MyKl-Y/MY-MP3/MY-MP3.kicad_pcb

## KiCad design MY-MP3.kicad_pcb (2025-10-29)

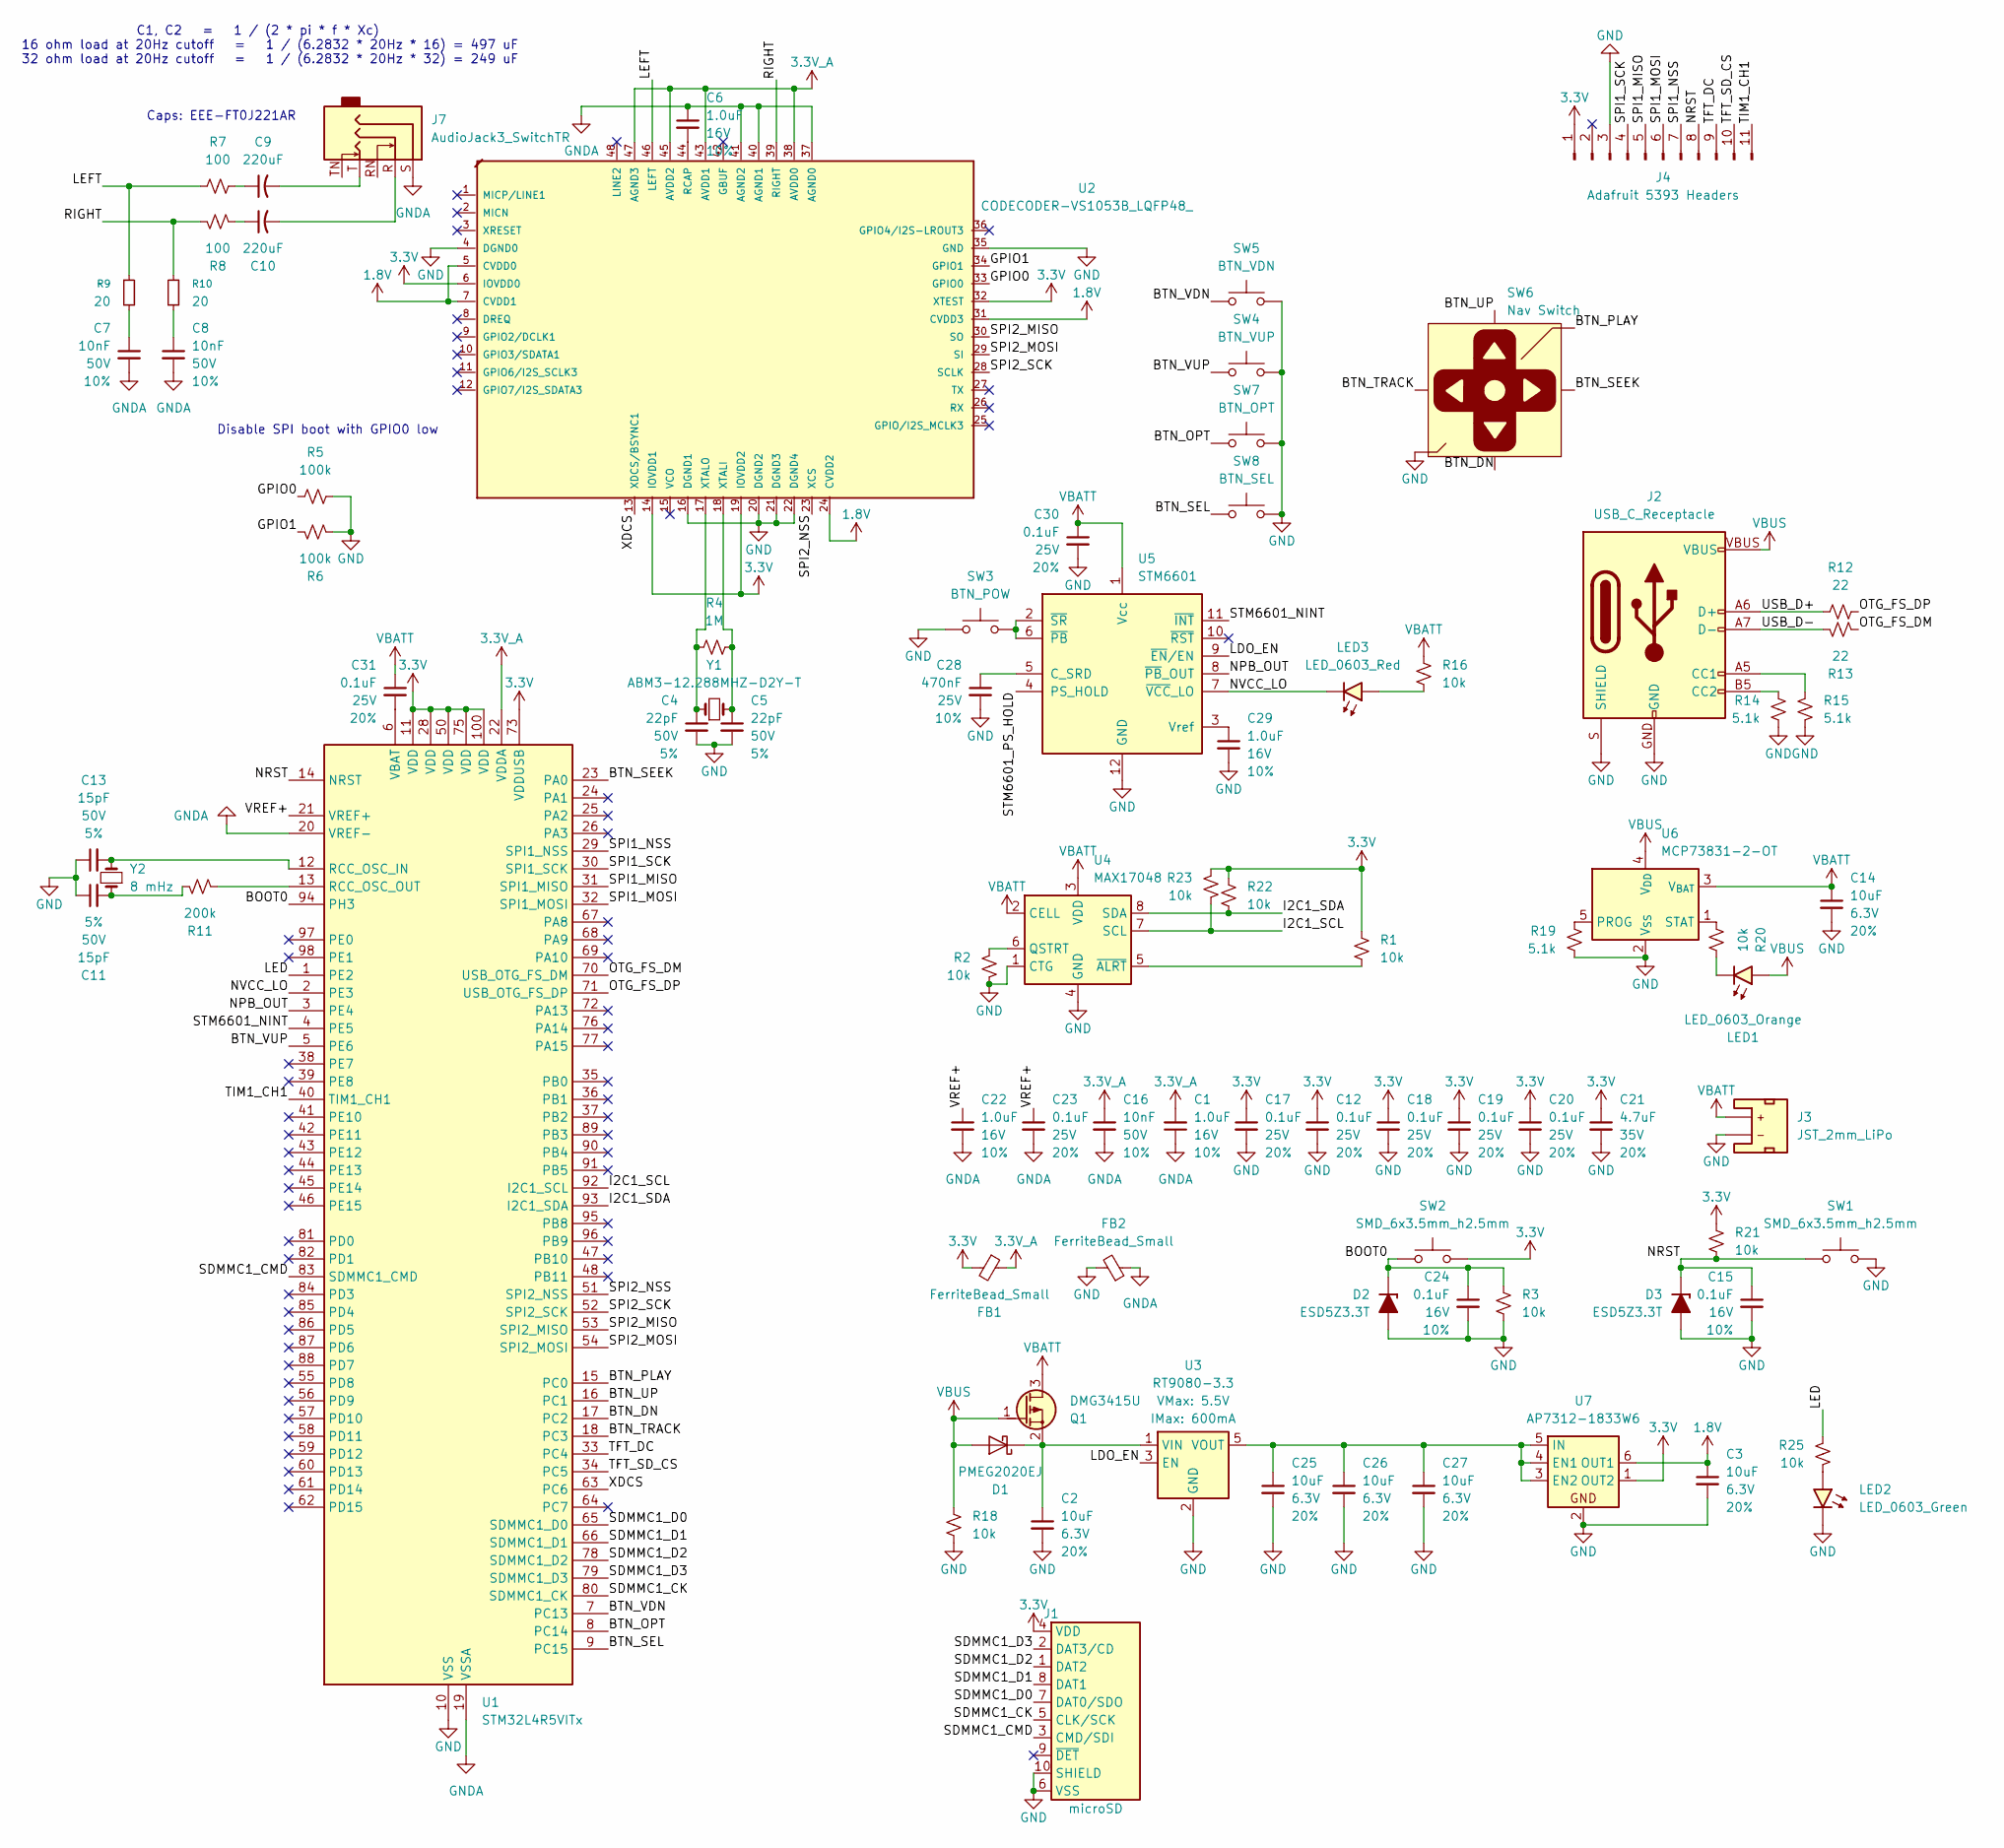
[picture p1: schematic MY-MP3.kicad_sch]

Parts:
C1, C6, C22, C29: 1.0uF; C_0402_1005Metric_Pad0.74x0.62mm; Voltage 16V; Tolerance 10%
C2, C3, C14, C25, C26, C27: 10uF; C_0402_1005Metric_Pad0.74x0.62mm; Voltage 6.3V; Tolerance 20%
C4, C5: 22pF; C_0402_1005Metric_Pad0.74x0.62mm; Voltage 50V; Tolerance 5%
C7, C8, C16: 10nF; C_0402_1005Metric_Pad0.74x0.62mm; Voltage 50V; Tolerance 10%
C9, C10: 220uF; CP_Elec_5x5.8
C11, C13: 15pF; C_0402_1005Metric_Pad0.74x0.62mm; Voltage 50V; Tolerance 5%
C12, C17, C18, C19, C20, C23, C30, C31: 0.1uF; C_0402_1005Metric_Pad0.74x0.62mm; Voltage 25V; Tolerance 20%
C15, C24: 0.1uF; C_0402_1005Metric_Pad0.74x0.62mm; Voltage 16V; Tolerance 10%
C21: 4.7uF; C_0402_1005Metric_Pad0.74x0.62mm; Voltage 35V; Tolerance 20%
C28: 470nF; C_0402_1005Metric_Pad0.74x0.62mm; Voltage 25V; Tolerance 10%
D1: PMEG2020EJ; D_SOD-323F
D2, D3: ESD5Z3.3T; D_SOD-523
FB1, FB2: FerriteBead_Small; L_0402_1005Metric_Pad0.77x0.64mm_HandSolder
J1: microSD; microSD_External_Pin
J2: USB_C_Receptacle; USB-C_16
J3: JST_2mm_LiPo; JST_1x02_P2.0mm_Horizontal_SMD
J4: Adafruit 5393 Headers; PinSocket_1x11_P2.54mm_Vertical
J7: AudioJack3_SwitchTR; Jack_3.5mm_CUI_SJ1-3525N_Horizontal
LED1: LED_0603_Orange; LED_0402_1005Metric_Orange
LED2: LED_0603_Green; LED_0402_1005Metric_Green
LED3: LED_0603_Red; LED_0402_1005Metric_Red
Q1: DMG3415U; SOT-23
R1, R2, R3, R16, R18, R20, R21, R22, R23, R25: 10k; R_0402_1005Metric
R4: 1M; R_0402_1005Metric
R5, R6: 100k; R_0402_1005Metric
R7, R8: 100; R_0402_1005Metric
R9, R10: 20; R_0201_0603Metric_Pad0.64x0.40mm_HandSolder
R11: 200k; R_0402_1005Metric
R12, R13: 22; R_0402_1005Metric
R14, R15, R19: 5.1k; R_0402_1005Metric
SW1, SW2: SMD_6x3.5mm_h2.5mm; Push_SMD_6x3.5mm; Mfg Part# 8-004 SMD Button 8x3.6mm Height=2.5mm
SW3: BTN_POW; Push_SMD_RA_4.5x3.4mm
SW4: BTN_VUP; Push_SMD_RA_4.5x3.4mm
SW5: BTN_VDN; Push_SMD_RA_4.5x3.4mm
SW6: Nav Switch; Navigation_SMD_9.9x9.9mm
SW7: BTN_OPT; Push_SMD_6x3.5mm; Mfg Part# 8-004 SMD Button 8x3.6mm Height=2.5mm
SW8: BTN_SEL; Push_SMD_6x3.5mm; Mfg Part# 8-004 SMD Button 8x3.6mm Height=2.5mm
U1: STM32L4R5VITx; LQFP-100_14x14mm_P0.5mm
U2: CODECODER-VS1053B_LQFP48_; LQFP-48_7x7mm_P0.5mm; MPN VS1053B
U3: RT9080-3.3; SOT23-5
U4: MAX17048; DFN-8_2x2mm_P0.5mm_EP1.2x0.8mm
U5: STM6601; TDFN-12_2x3mm_P0.5mm
U6: MCP73831-2-OT; SOT-23-5
U7: AP7312-1833W6; SOT-23-6
Y1: ABM3-12.288MHZ-D2Y-T; Crystal_SMD_Abracon_ABM3-2Pin_5.0x3.2mm_HandSoldering
Y2: 8 mHz; Crystal_SMD_Abracon_ABM3-2Pin_5.0x3.2mm_HandSoldering

Connections:
1.8V: C3.1, U2.5 (CVDD0), U2.7 (CVDD1), U2.24 (CVDD2), U2.31 (CVDD3), U7.6 (OUT1)
3.3V: C12.1, C17.1, C18.1, C19.1, C20.1, C21.1, FB1.2, J1.4 (VDD), J4.1, R1.2, R21.1, R22.2, R23.2, SW2.1, U1.11 (VDD), U1.28 (VDD), U1.50 (VDD), U1.73 (VDDUSB), U1.75 (VDD), U1.100 (VDD), U2.6 (IOVDD0), U2.14 (IOVDD1), U2.19 (IOVDD2), U2.32 (XTEST), U7.1 (OUT2)
3.3V_A: C1.2, C16.1, FB1.1, U1.22 (VDDA), U2.38 (AVDD0), U2.43 (AVDD1), U2.45 (AVDD2), U2.47 (AGND3)
/BOOT0: C24.1, D2.1 (K), R3.1, SW2.2, U1.94 (PH3)
/BTN_DN: SW6.5 (Down), U1.17 (PC2)
/BTN_OPT: SW7.1, U1.8 (PC14)
/BTN_PLAY: SW6.4 (Center), U1.15 (PC0)
/BTN_SEEK: SW6.2 (Right), U1.23 (PA0)
/BTN_SEL: SW8.1, U1.9 (PC15)
/BTN_TRACK: SW6.7 (Left), U1.18 (PC3)
/BTN_UP: SW6.1 (Up), U1.16 (PC1)
/BTN_VDN: SW5.1, U1.7 (PC13)
/BTN_VUP: SW4.1, U1.5 (PE6)
/GPIO0: R5.1, U2.33 (GPIO0)
/GPIO1: R6.1, U2.34 (GPIO1)
/I2C1_SCL: R23.1, U1.92 (I2C1_SCL), U4.7 (SCL)
/I2C1_SDA: R22.1, U1.93 (I2C1_SDA), U4.8 (SDA)
/LDO_EN: U3.3 (EN), U5.9 (~EN/EN)
/LED: R25.2, U1.1 (PE2)
/LEFT: R7.1, R9.1, U2.46 (LEFT)
/NPB_OUT: U1.3 (PE4), U5.8 (~PB_OUT)
/NRST: C15.1, D3.1 (K), J4.8, R21.2, SW1.1, U1.14 (NRST)
/NVCC_LO: LED3.1 (K), U1.2 (PE3), U5.7 (~VCC_LO)
/OTG_FS_DM: R13.2, U1.70 (USB_OTG_FS_DM)
/OTG_FS_DP: R12.2, U1.71 (USB_OTG_FS_DP)
/RIGHT: R8.1, R10.1, U2.39 (RIGHT)
/SDMMC1_CK: J1.5 (CLK/SCK), U1.80 (SDMMC1_CK)
/SDMMC1_CMD: J1.3 (CMD/SDI), U1.83 (SDMMC1_CMD)
/SDMMC1_D0: J1.7 (DAT0/SDO), U1.65 (SDMMC1_D0)
/SDMMC1_D1: J1.8 (DAT1), U1.66 (SDMMC1_D1)
/SDMMC1_D2: J1.1 (DAT2), U1.78 (SDMMC1_D2)
/SDMMC1_D3: J1.2 (DAT3/CD), U1.79 (SDMMC1_D3)
/SPI1_MISO: J4.5, U1.31 (SPI1_MISO)
/SPI1_MOSI: J4.6, U1.32 (SPI1_MOSI)
/SPI1_NSS: J4.7, U1.29 (SPI1_NSS)
/SPI1_SCK: J4.4, U1.30 (SPI1_SCK)
/SPI2_MISO: U1.53 (SPI2_MISO), U2.30 (SO)
/SPI2_MOSI: U1.54 (SPI2_MOSI), U2.29 (SI)
/SPI2_NSS: U1.51 (SPI2_NSS), U2.23 (XCS)
/SPI2_SCK: U1.52 (SPI2_SCK), U2.28 (SCLK)
/STM6601_NINT: U1.4 (PE5), U5.11 (~INT)
/STM6601_PS_HOLD: U5.4 (PS_HOLD)
/TFT_DC: J4.9, U1.33 (PC4)
/TFT_SD_CS: J4.10, U1.34 (PC5)
/TIM1_CH1: J4.11, U1.40 (TIM1_CH1)
/USB_D+: J2.A6 (D+), J2.B6 (D+), R12.1
/USB_D-: J2.A7 (D-), J2.B7 (D-), R13.1
/VREF+: C22.1, C23.1, U1.21 (VREF+)
/XDCS: U1.63 (PC6), U2.13 (XDCS/BSYNC1)
GND: C2.2, C3.2, C4.2, C5.2, C11.1, C12.2, C13.1, C14.2, C15.2, C17.2, C18.2, C19.2, C20.2, C21.2, C24.2, C25.2, C26.2, C27.2, C28.2, C29.2, C30.2, D2.2 (A), D3.2 (A), FB2.2, J1.6 (VSS), J1.10 (SHIELD), J2.GND, J2.S (SHIELD), J3.1 (-), J4.3, LED2.1 (K), R2.1, R3.2, R5.2, R6.2, R14.1, R15.1, R18.1, R19.1, SW1.2, SW3.1, SW4.2, SW5.2, SW6.3 (GND), SW6.6 (GND), SW6.8 (GND), SW6.9 (GND), SW6.10 (GND), SW7.2, SW8.2, U1.10 (VSS), U1.27 (VSS), U1.49 (VSS), U1.74 (VSS), U1.99 (VSS), U2.4 (DGND0), U2.16 (DGND1), U2.20 (DGND2), U2.21 (DGND3), U2.22 (DGND4), U2.35 (GND), U3.2 (GND), U4.1 (CTG), U4.4 (GND), U4.9 (GND), U5.12 (GND), U6.2 (V_{SS}), U7.2
GNDA: C1.1, C6.1, C7.2, C8.2, C16.2, C22.2, C23.2, FB2.1, J7.S, U1.19 (VSSA), U1.20 (VREF-), U2.37 (AGND0), U2.40 (AGND1), U2.41 (AGND2)
unnamed: C7.1, R9.2
unnamed: C8.1, R10.2
unnamed: C9.1, R7.2
unnamed: C9.2, J7.T
unnamed: C10.1, R8.2
unnamed: C10.2, J7.R
unnamed: C11.2, R11.2, Y2.1
unnamed: C2.1, D1.1 (K), Q1.2 (S), U3.1 (VIN)
unnamed: J2.A5 (CC1), R15.2
unnamed: J2.B5 (CC2), R14.2
unnamed: LED1.1 (K), R20.1
unnamed: LED2.2 (A), R25.1
unnamed: LED3.2 (A), R16.1
unnamed: C13.2, U1.12 (RCC_OSC_IN), Y2.2
unnamed: R11.1, U1.13 (RCC_OSC_OUT)
unnamed: C31.2, U1.6 (VBAT)
unnamed: C6.2, U2.44 (RCAP)
unnamed: C5.1, R4.2, U2.18 (XTALI), Y1.2
unnamed: C4.1, R4.1, U2.17 (XTALO), Y1.1
unnamed: C25.1, C26.1, C27.1, U3.5 (VOUT), U7.3 (EN2), U7.4 (EN1), U7.5 (IN)
unnamed: R2.2, U4.6 (QSTRT)
unnamed: R1.1, U4.5 (~ALRT)
unnamed: C28.1, U5.5 (C_SRD)
unnamed: C29.1, U5.3 (Vref)
unnamed: SW3.2, U5.2 (~SR), U5.6 (~PB)
unnamed: R19.2, U6.5 (PROG)
unnamed: R20.2, U6.1 (STAT)
VBATT: C14.1, C30.1, C31.1, J3.2 (+), Q1.3 (D), R16.2, U4.2 (CELL), U4.3 (VDD), U5.1 (Vcc), U6.3 (V_{BAT})
VBUS: D1.2 (A), J2.VBUS, LED1.2 (A), Q1.1 (G), R18.2, U6.4 (V_{DD})

Notes on the sheet:
Disable SPI boot with GPIO0 low
C1, C2 = 1 / (2 * pi * f * Xc) 16 ohm load at 20Hz cutoff = 1 / (6.2832 * 20Hz * 16) = 497 uF 32 ohm load at 20Hz cutoff = 1 / (6.2832 * 20Hz * 32) = 249 uF
Caps: EEE-FT0J221AR

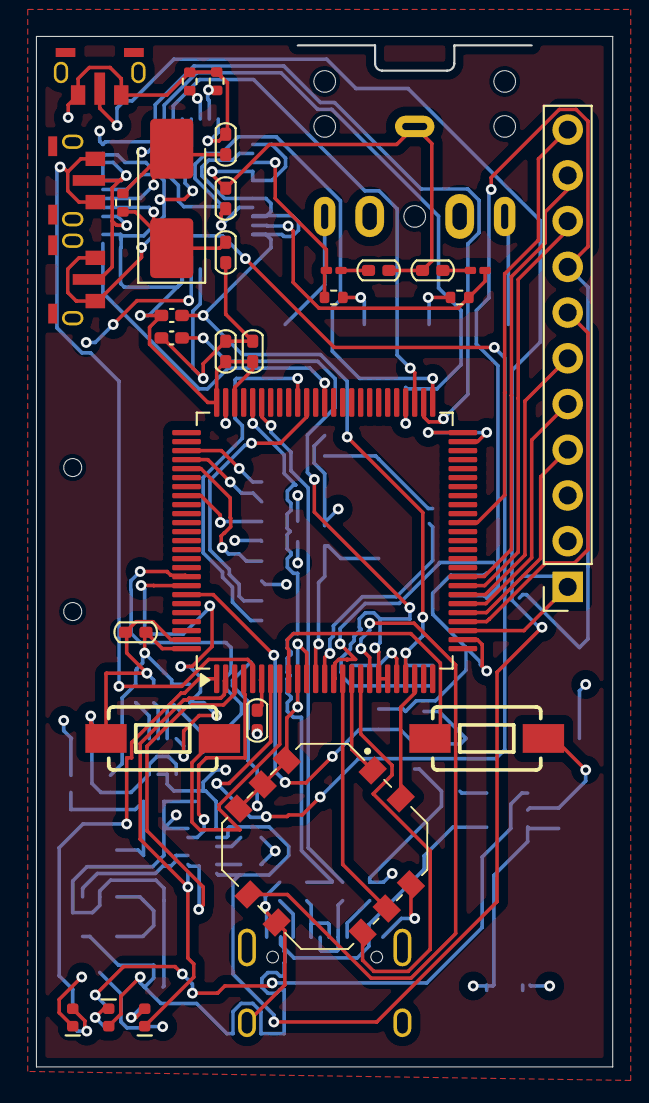
[picture p2: board MY-MP3.kicad_pcb from above]

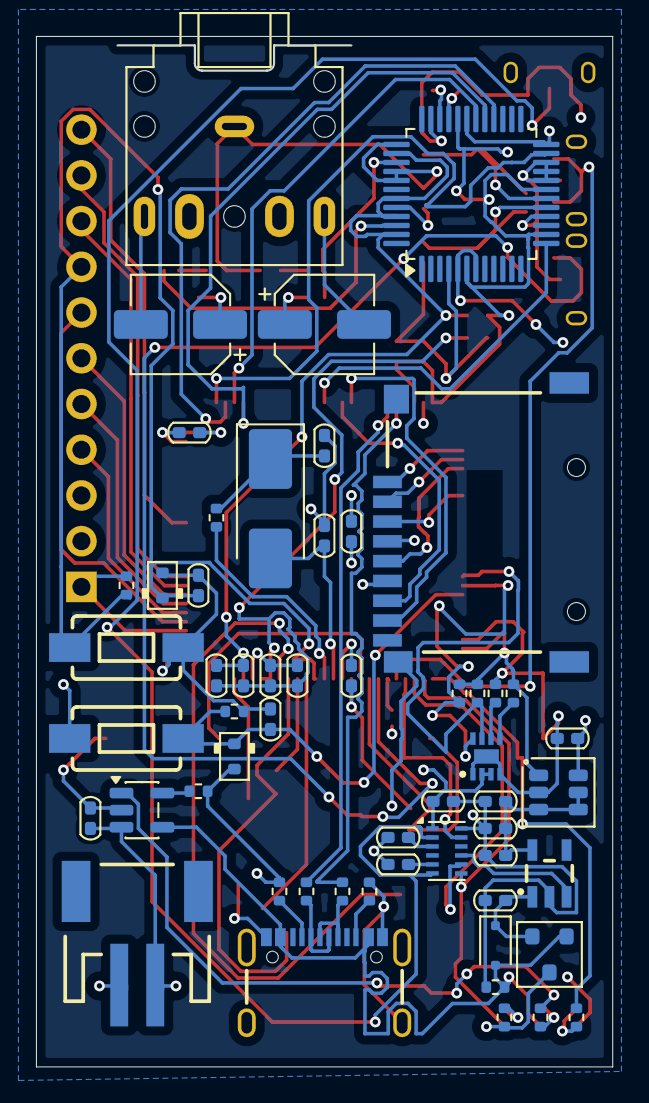
[picture p3: board MY-MP3.kicad_pcb from below]

Board: 4 copper layers, 32.0 x 57.2 mm, 85 parts (55 on the bottom side), 79 nets.
