MyKl-Y/MY-MP3/(commit log)

2025-10-24 'Finished' schematic for MP3 player
    [MY-MP3.kicad_pcb, MY-MP3.kicad_sch]
2025-10-28 Added some buttons and started the on off hardware functionallity
    [MY-MP3.kicad_pcb, MY-MP3.kicad_sch]
2025-10-28 Finish Schematic and start PCB
    [MY-MP3.kicad_pcb, MY-MP3.kicad_sch]
2025-10-29 Finish PCB
    [MY-MP3.kicad_pcb]
2025-10-29 Redo PCB for smaller size and better bin placements
    [MY-MP3-B_Cu.gbl, MY-MP3-B_Mask.gbs, MY-MP3-B_Paste.gbp, MY-MP3-B_Silkscreen.gbo, MY-MP3-Edge_Cuts.gm1, MY-MP3-F_Cu.gtl, MY-MP3-F_Mask.gts, MY-MP3-F_Paste.gtp]
